vishnuvijayn395/pipet/OneDrive_1_8-5-2026/stage_tab_light_theme_1784133457223.png

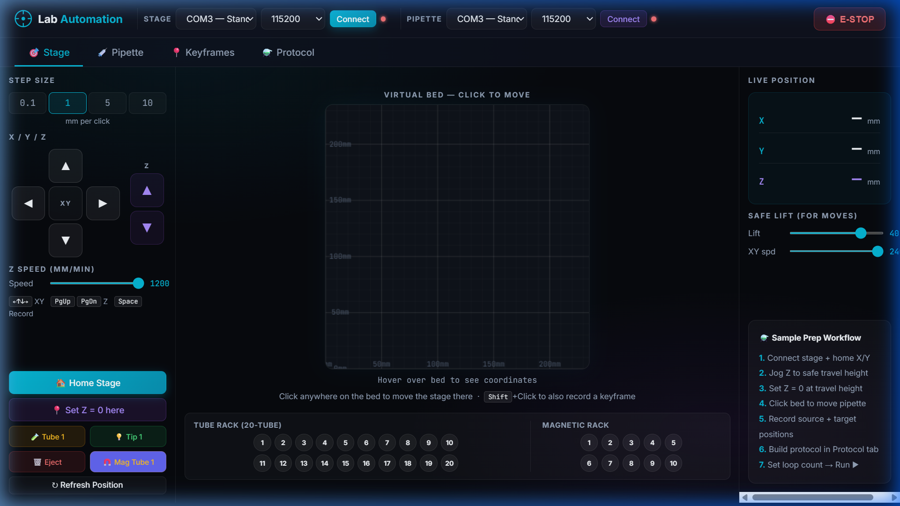
OneDrive_1_8-5-2026/stage_tab_light_theme_1784133457223.png
