vishnuvijayn395/pipet/OneDrive_1_8-5-2026/presentations/electronic_pipette.pptx

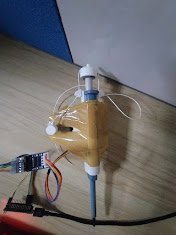
[picture p14: figure]

Prototype v1

Electronic Pipette

Proof of Concept and Initial Hardware Integration

ka

Kahaan Padiya

## Slide 2

The Problem with Manual Pipetting

😓 Repetitive Strain

Hundreds of pipette strokes per day cause thumb and wrist fatigue, leading to RSI in lab technicians.

📉 Human Variability

Manual force inconsistency introduces volume error. CV of manual pipetting can exceed 1–2% for small volumes.

💸 Cost of Error

Inaccurate dispensing wastes expensive reagents and can invalidate entire experiment runs.

⚡ Our Goal

Build a low-cost electronic pipette using off-the-shelf components to improve consistency.

## Slide 3

Hardware Components

01

Arduino Nano

Microcontroller brain. Stores calibration positions in EEPROM, handles serial commands (PREP / ASP / DISP) and jog control.

Provides precise angular positioning. The driver board enables control and handles the current requirements of the Stepper.

Converts rotary Stepper motion into linear plunger travel. String is routed over two force-redirector for smooth, vertical actuation.

Browser-based UI (Web Serial API). No app install needed — connect over USB, calibrate endpoints, and run standard pipetting protocol.

A limit switch at maximum plunger depth will kill the motor, protecting the mechanism and auto-detecting the blowout position.

02

Stepper Motor + Driver

03

Pulley & String System

04

Web Serial Controller

05

Future: Pressure Switch

## Slide 4

Operating Protocol

Three Physical buttons on the pipette to control each stage

PREP

PREP Button

1. Push to First Stop

Press PREP button. Stepper drives plunger to pre-aspirate position and establishes consistent volume baseline before liquid contact.

ASP

ASP Button

2. Aspirate

Press ASP button. Motor retracts plunger to calibrated aspirate depth. Immerse tip first; negative pressure draws liquid in accurately.

DISP

DISP Button

3. Dispense & Blowout

Press DISP button. Full plunger travel to second stop — dispenses volume and completes blowout, expelling all residual liquid.

## Slide 5

Two Interfaces, Two Roles

LAPTOP · One-Time Calibration

Done once. Saved permanently to EEPROM.

Jog UP / DOWN

Use ↑↓ buttons to manually position plunger at the desired depth.

Set Open Position (ZERO)

Save the resting / top-of-travel position. Plunger fully retracted.

Save 1st Stop (Aspirate)

Motor at the exact depth that draws the correct volume into the tip.

Save 2nd Stop (Blowout)

Deepest point : full plunger depression to expel all residual liquid.

Recalibrate only when needed.

PHYSICAL BUTTONS (V1.1) · Daily Operation

No laptop. Just the pipette.

PREP

Push to 1st Stop

ASP

Aspirate Liquid

DISP

Dispense & Blowout

Reads positions from EEPROM at boot. Works standalone.

1

2

VS

3

4

## Slide 6

Precision Comparison: Normal vs Electronic

Manual Pipette

Readings taken at 520nm

Electronic Pipette (v1)

0.47792

0.47687

0.47757

0.54012

0.56028

0.47685

0.47641

0.47592

0.56806

0.54440

Metric | Manual | Electronic
Average | 0.4769 | 0.5532
σ (Sigma) | 0.000733 | 0.01316
3σ | 0.00220 | 0.03948
CV % | 0.154% | 2.379%
3×CV | 0.461% | 7.136%

## Slide 7

Measurement Spread Visualised

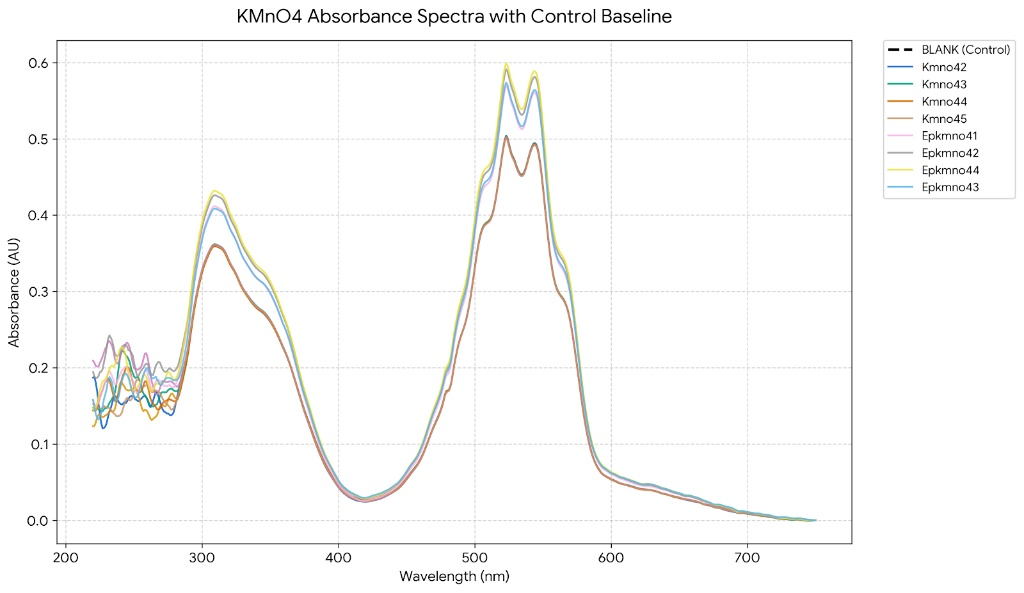
[picture p15: figure]

## Slide 8

Roadmap & Future Improvements

Pressure / Limit Switch + control buttons

Mount a microswitch at maximum plunger depth. Arduino kills motor on trigger. Add Buttons to control Prep, aspirate and dispense.

v1.1

Auto-Calibration Mode

On boot, motor travels to limit switch to find true zero automatically. Calibration saved without manual jog steps.

v1.2

In Progress

Planned

Encoder Feedback

Rotary encoder on Stepper shaft provides closed-loop position control dramatically reduces CV by eliminating string slack error.

v2.0

Volume Selection UI

Add a volume input to the web controller. Software maps desired µL to encoder ticks for flexible, calibrated aspiration.

v2.1

Planned

Future

## Slide 9

Conclusion

A working proof-of-concept in a form factor that costs a fraction of commercial alternatives.

✅ Functional 3-command pipetting protocol over USB Serial

✅ EEPROM-persisted calibration — survives power cycles

✅ Web based browser controller — no install required

📊 CV of 2.38% vs 0.15% manual — improvement path identified

🔧 Pressure switch (v1.1) will fix primary source of error

Built with: Arduino Nano · Stepper Motor · Web Serial API · EEPROM · Open Hardware
