vishnuvijayn395/pipet/OneDrive_1_8-5-2026/presentations/electronic_pipette_v3 (1).pptx

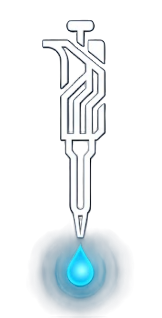
[picture p16: figure]

Electronic Pipette

Prototype v2 · Linear actuator

Precision Improvement via Linear Stepper Control
Comparative Analysis: Control · v1 · v2

Kahaan Padiya · June 2026

## Slide 2

What is v2 — Linear Step Parametrisation

🔩 Linear Actuator step Control

Replaces the Pulley system with force directors, with a industrial grade linear actuator, providing no backlash and much higher precision, Repeatability

📐 Automatic Calibration

Step parameters are configurable via serial interface. At startup, the pipette automatically homes using a contact switch at the bottom of piston stroke. Volume maps directly to step count, enabling reproducible and tunable aspiration depth.

🧪 Tighter Test Protocol

The readings are taken at 8uL, down from the 50uL, showing that the improvement in variation stays constant at lower volumes.

🎯 Target Improvement

v1 showed CV of 2.38% – mainly from string-slack at mechanical stops. v3 aims to bring CV below 0.8% by removing the string and using a direct screw drive.

## Slide 3

Raw Readings @ 520 nm — All Three Conditions

Direct absorbance values used for statistical comparison

Manual Pipette (Control)

Electronic v1

Electronic v3 (Linear Step)

Reading 1

0.47792

Reading 1

0.54012

Reading 1

0.57070

Reading 2

0.47687

Reading 2

0.56028

Reading 2

0.57237

Reading 3

0.47757

Reading 3

0.56806

Reading 3

0.57199

Reading 4

0.47685

n = 4

Reading 4

0.54440

Reading 4

0.57524

n = 6

Reading 5

Reading 6

0.47641

0.47592

n = 5

Reading 5

0.56357

## Slide 4

Precision Metrics — Control vs v1 vs v3

Metric

Manual (Control)

Electronic v1

Electronic v3 (Linear)

Average

0.47692

0.55322

0.57077

σ (Sigma)

0.000733

0.01316

0.00436

3σ

0.00220

0.0395

0.01307

CV %

0.154%

2.379%

0.763%

3×CV

0.461%

7.136%

2.289%

Readings taken at 520 nm · Pathlength 10 mm · Green = best, Red = worst CV

## Slide 5

CV % Comparison — Improvement Across Versions

Control CV

0.154%

v1 CV

2.379%

v3 CV

0.763%

v3 is 68% better CV than v1

## Slide 6

Individual Reading Spread — All Conditions

## Slide 7

Analysis — What v3 Tells Us

✅ CV cut from 2.38% → 0.76%

Linear step control dramatically reduced inter-reading variability. The 68% improvement over v1 confirms that string-slack at mechanical stops was the dominant source of error.

📊 Volume control implemented

Through weighing scale calibration, we can now correlate volume with step count, and control the volume via the app interface

⚠️ Still 5× above manual baseline

Control CV = 0.154%. v3 at 0.76% is a major step forward but further work remains. Likely sources: Flex in 3d print, loss of motor power due to sideways torque

🔧 Next steps to close the gap

Adding a pressure switch for self calibration

## Slide 8

Conclusion

Electronic Pipette v3 — Linear Step Parametrisation

✅ CV reduced from 2.38% (v1) → 0.76% (v3) — a 68% improvement

✅ Linear step control eliminates stop-dependency and string-slack errors

✅ 3σ band tightened from 0.0395 (v1) to 0.0131 (v3) absorbance units

✅ Volume control enabled using step count and calibration with weighing scale
