vishnuvijayn395/pipet/OneDrive_1_8-5-2026/current_stage_tab_1784134485276.png

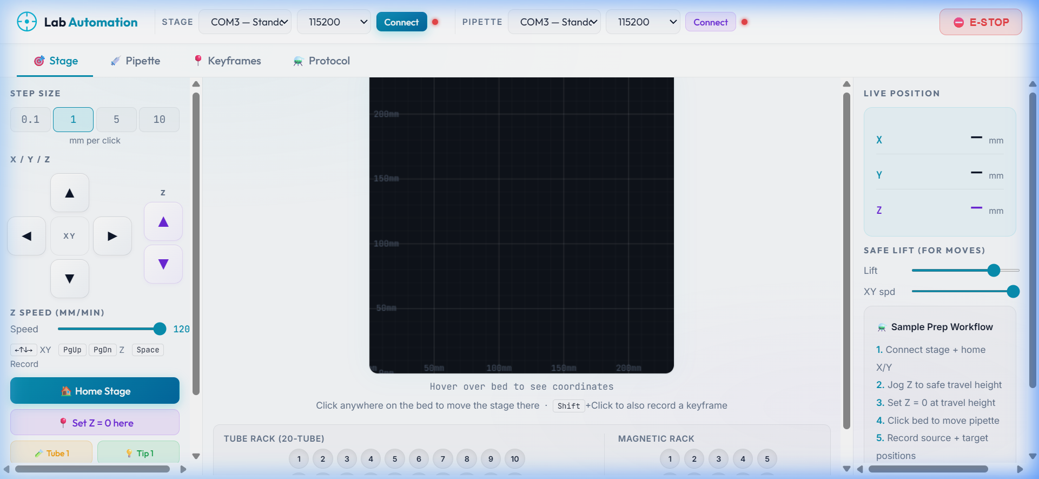
OneDrive_1_8-5-2026/current_stage_tab_1784134485276.png
