vishnuvijayn395/pipet/OneDrive_1_8-5-2026/graphs/overlapping_spectra.png

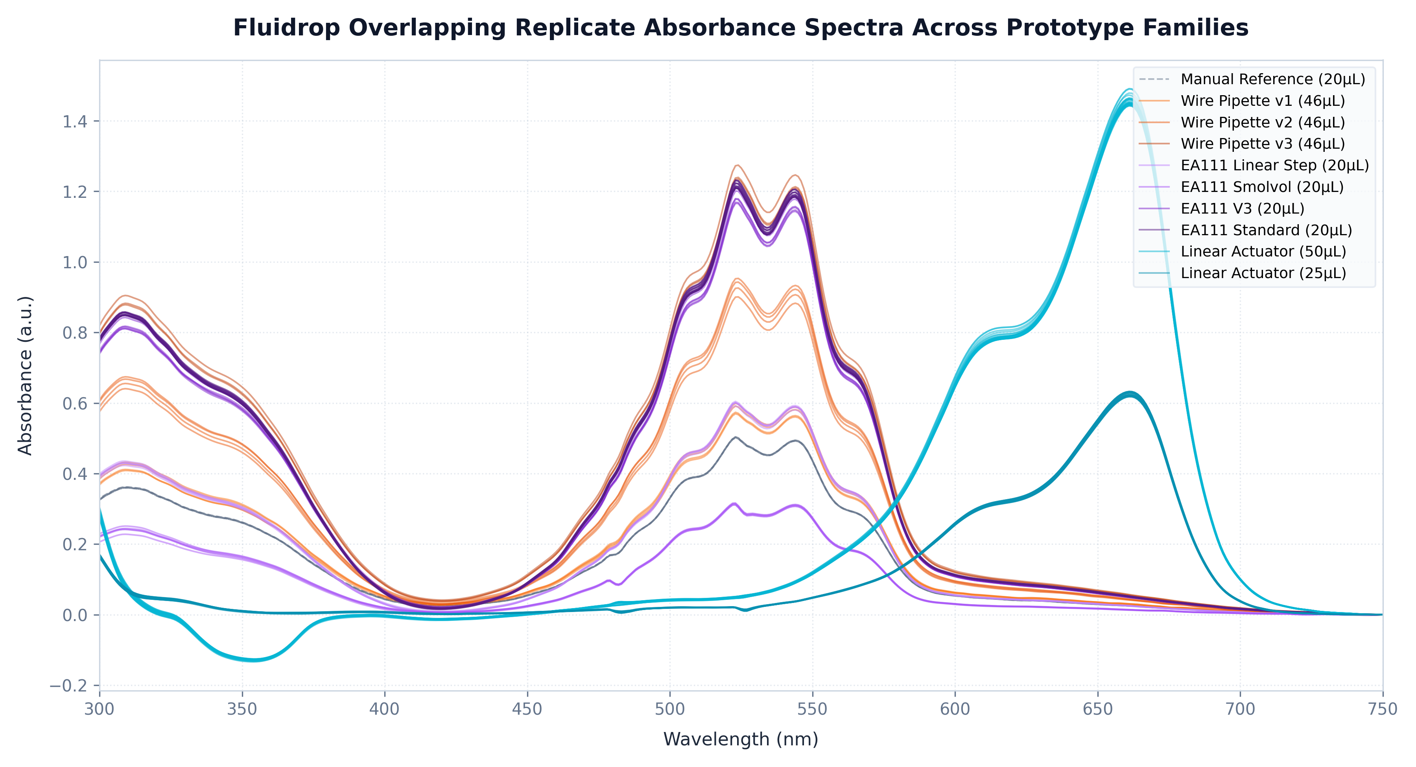
OneDrive_1_8-5-2026/graphs/overlapping_spectra.png
