vishnuvijayn395/pipet/OneDrive_1_8-5-2026/graphs/precision_evolution.png

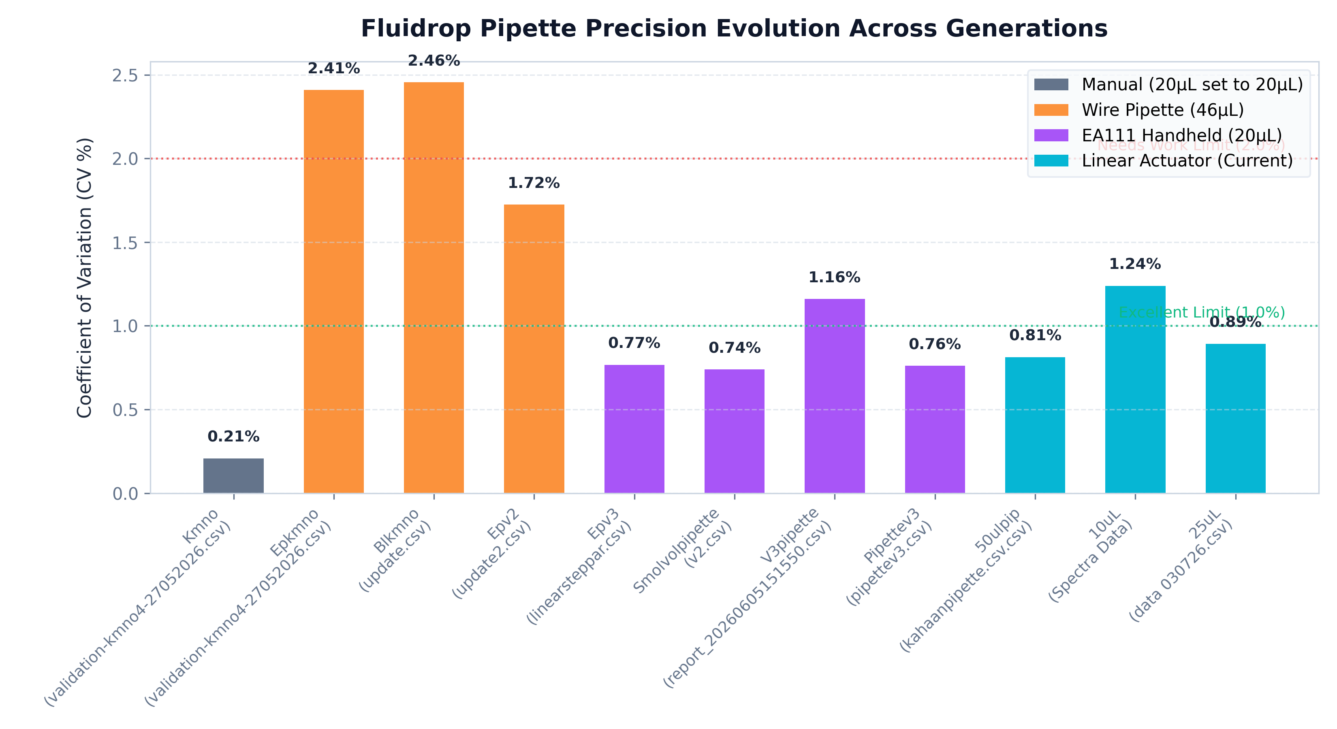
OneDrive_1_8-5-2026/graphs/precision_evolution.png
