vishnuvijayn395/pipet/OneDrive_1_8-5-2026/3d files/Final linear actuator parts/newstrongholder.stl

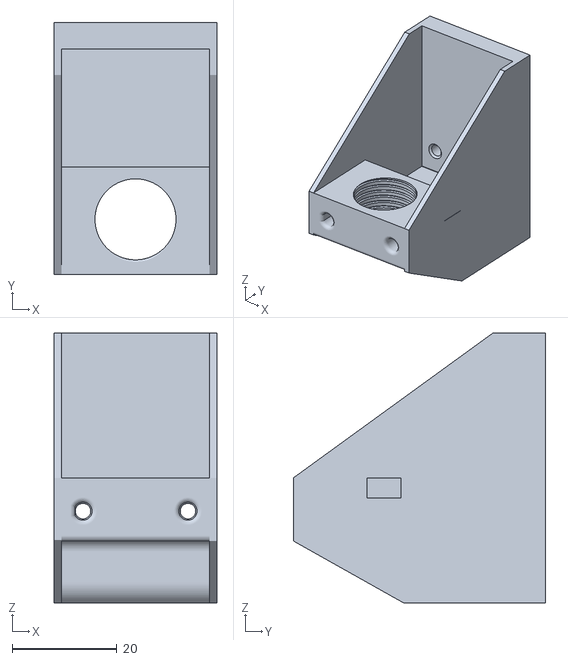
[picture p20: CAD file, 2026-10-06]
OneDrive_1_8-5-2026/3d files/Final linear actuator parts/newstrongholder.stl
31.0 x 48.0 x 51.4
