vishnuvijayn395/pipet/OneDrive_1_8-5-2026/3d files/Handheld linear actuator prototype casing/lowerpipette.stl

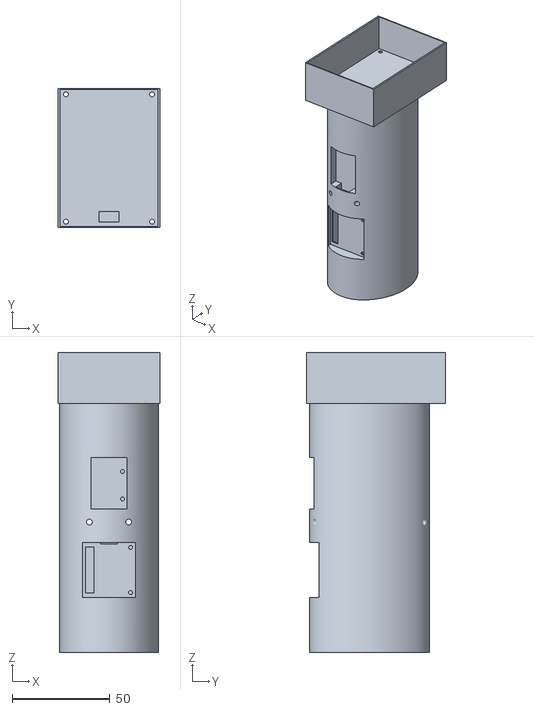
[picture p21: CAD file, 2026-10-06]
OneDrive_1_8-5-2026/3d files/Handheld linear actuator prototype casing/lowerpipette.stl
52.0 x 71.0 x 153.2
