vishnuvijayn395/pipet/OneDrive_1_8-5-2026/3d files/Linear actuator prototype/pushpin.stl

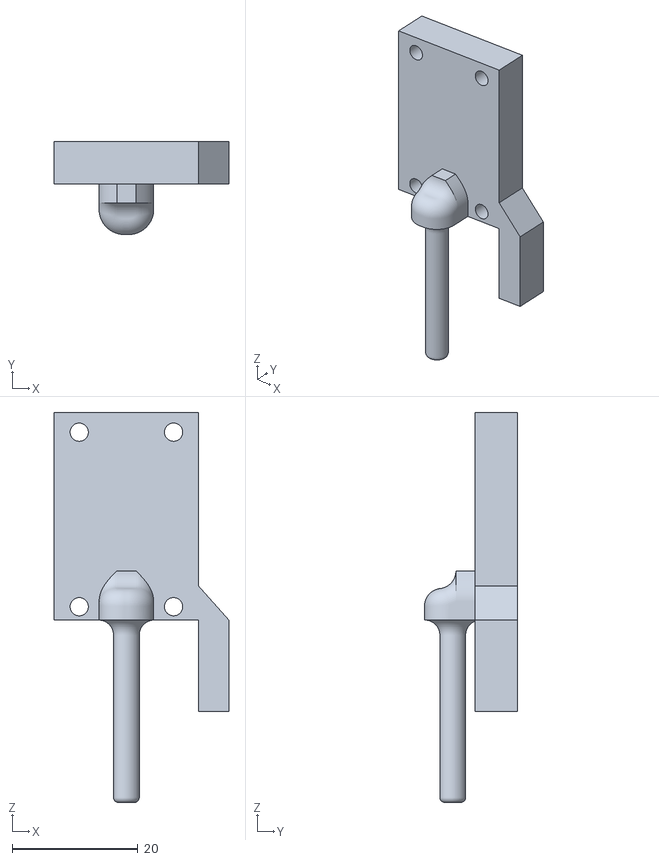
[picture p22: CAD file, 2026-10-06]
OneDrive_1_8-5-2026/3d files/Linear actuator prototype/pushpin.stl
27.8 x 14.8 x 62.0
