vishnuvijayn395/pipet/OneDrive_1_8-5-2026/3d files/PipetteLinearActuatorPrototypeA.3mf

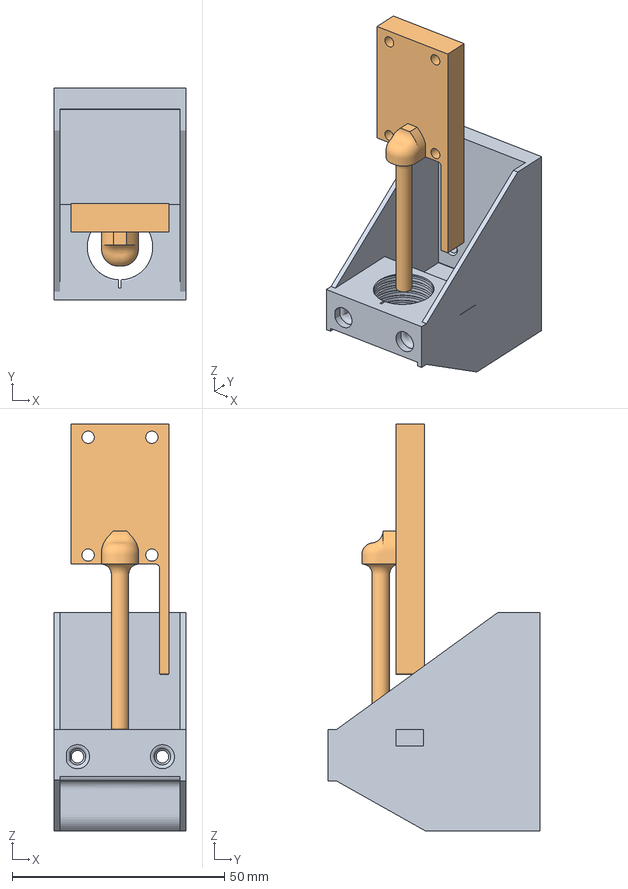
[picture p23: CAD file, 2026-10-06]
OneDrive_1_8-5-2026/3d files/PipetteLinearActuatorPrototypeA.3mf
31.0 x 50.0 x 95.9 mm
