vishnuvijayn395/pipet/OneDrive_1_8-5-2026/3d files/prototype 1 - Pulley/pulley.3mf

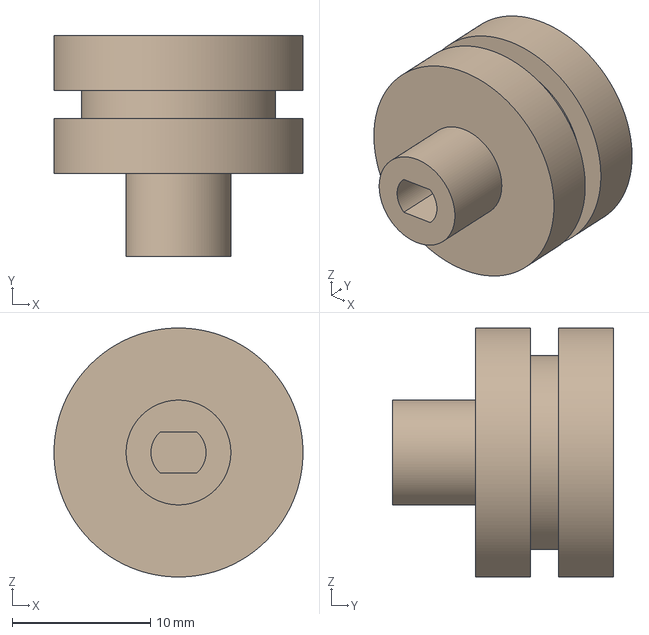
[picture p24: CAD file, 2026-10-06]
OneDrive_1_8-5-2026/3d files/prototype 1 - Pulley/pulley.3mf
18.0 x 16.0 x 18.0 mm
