vishnuvijayn395/pipet/OneDrive_1_8-5-2026/3d files/Syringe prototype parts/Syringepipettewithguiderod.stl

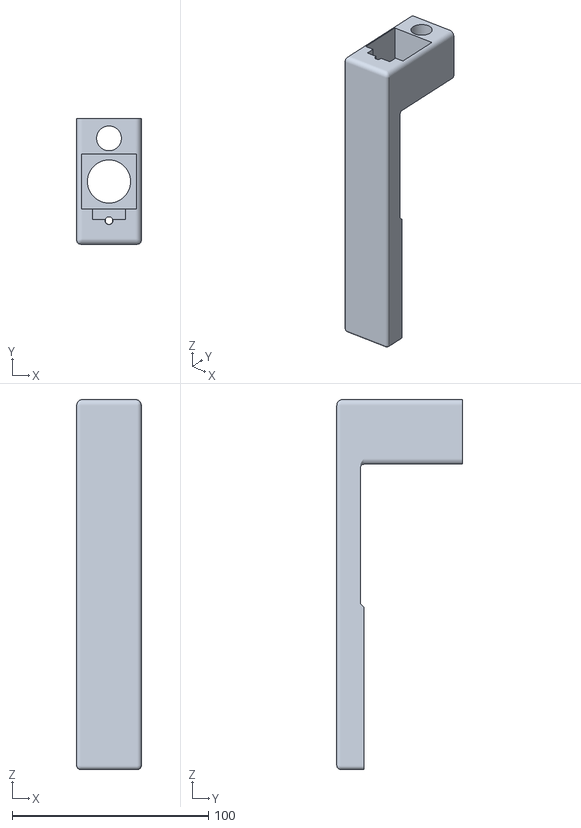
[picture p26: CAD file, 2026-10-06]
OneDrive_1_8-5-2026/3d files/Syringe prototype parts/Syringepipettewithguiderod.stl
33.0 x 64.0 x 188.7
