vishnuvijayn395/pipet/OneDrive_1_8-5-2026/3d files/ec11_encoder_knob.3mf

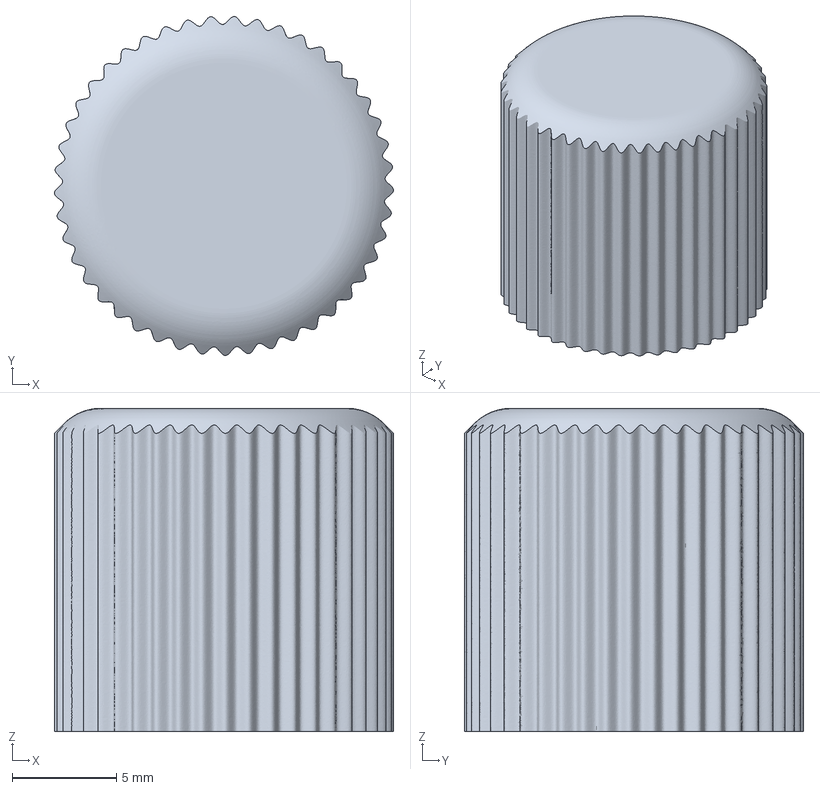
[picture p27: CAD file, 2026-10-06]
OneDrive_1_8-5-2026/3d files/ec11_encoder_knob.3mf
16.3 x 16.2 x 15.5 mm
