vishnuvijayn395/pipet/OneDrive_1_8-5-2026/3d files/Final linear actuator parts/newstrongpin.stl

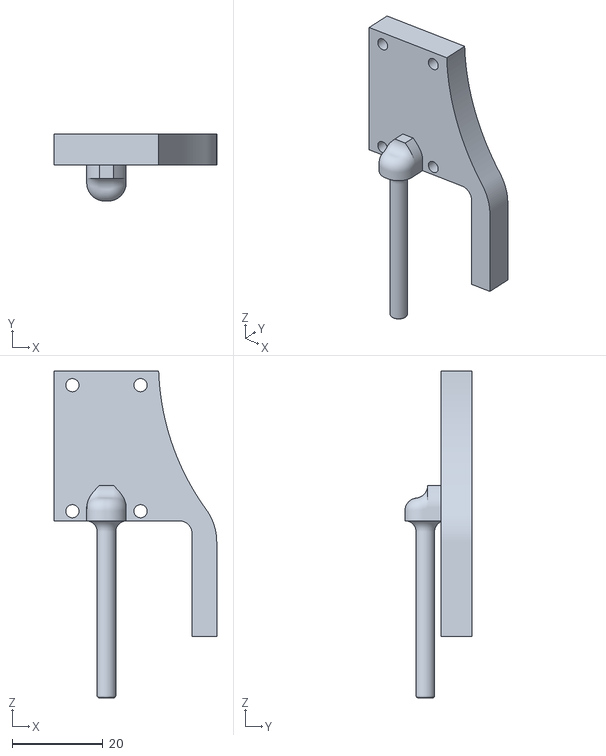
[picture p28: CAD file, 2026-10-06]
OneDrive_1_8-5-2026/3d files/Final linear actuator parts/newstrongpin.stl
35.8 x 14.8 x 72.0
