vishnuvijayn395/pipet/OneDrive_1_8-5-2026/3d files/prototype 1 - Pulley/V and motor mount.3mf

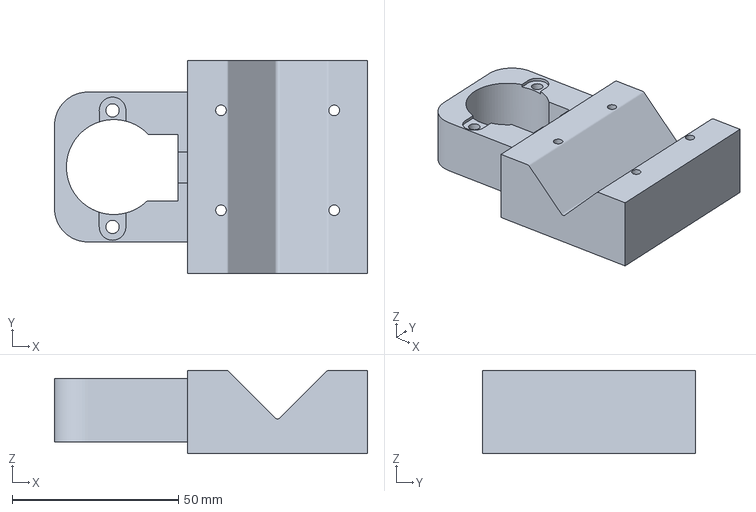
[picture p29: CAD file, 2026-10-06]
OneDrive_1_8-5-2026/3d files/prototype 1 - Pulley/V and motor mount.3mf
94.0 x 64.0 x 25.0 mm
