vishnuvijayn395/pipet/OneDrive_1_8-5-2026/3d files/Prototype 2 - Handheld EA111/pipettepart2.stl

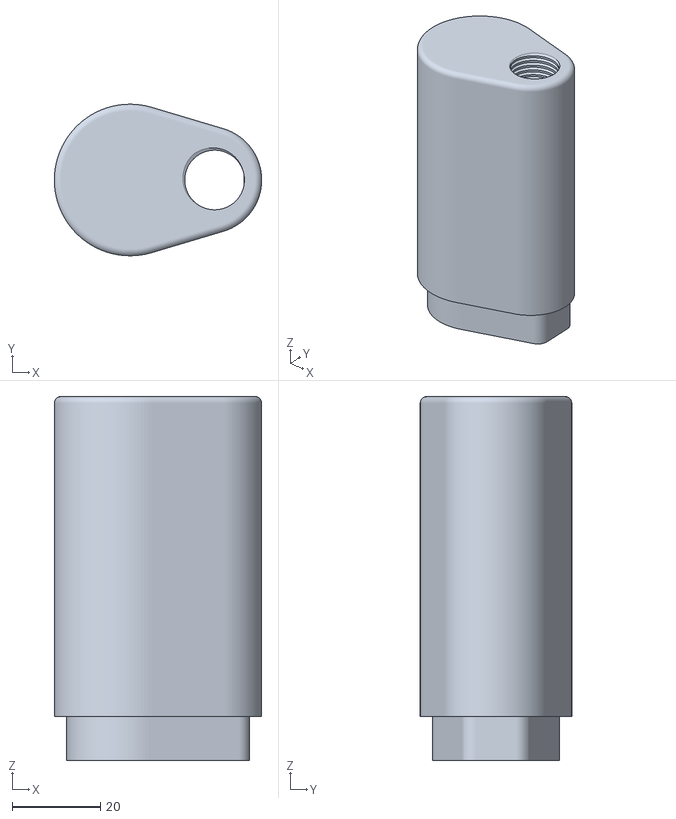
[picture p30: CAD file, 2026-10-06]
OneDrive_1_8-5-2026/3d files/Prototype 2 - Handheld EA111/pipettepart2.stl
47.1 x 34.4 x 82.6
