vishnuvijayn395/pipet/OneDrive_1_8-5-2026/3d files/Prototype 2 - Handheld EA111/connectorfixed.stl

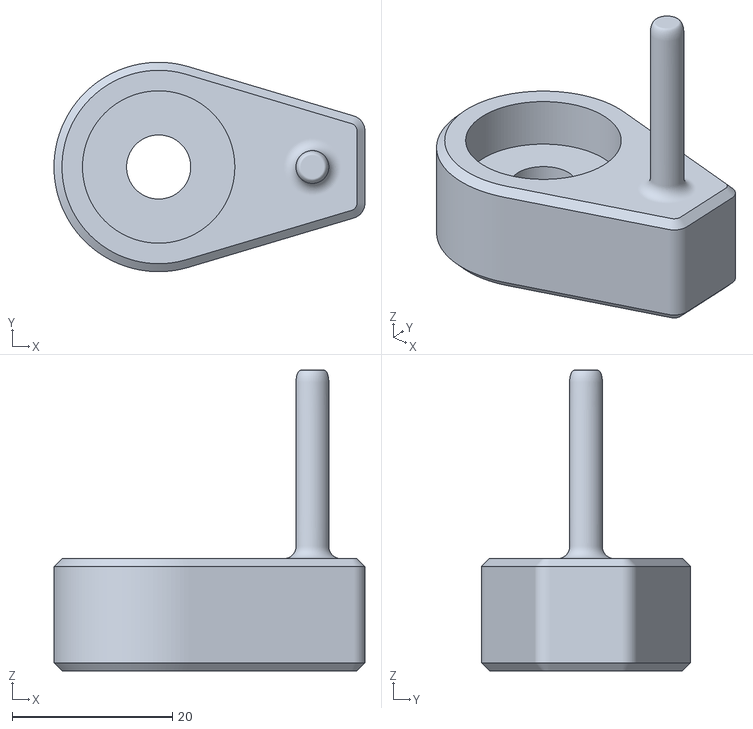
[picture p32: CAD file, 2026-10-06]
OneDrive_1_8-5-2026/3d files/Prototype 2 - Handheld EA111/connectorfixed.stl
38.8 x 26.1 x 37.5
