vishnuvijayn395/pipet/OneDrive_1_8-5-2026/3d files/Syringe prototype parts/Syringepipettewithguiderod_Holder.stl

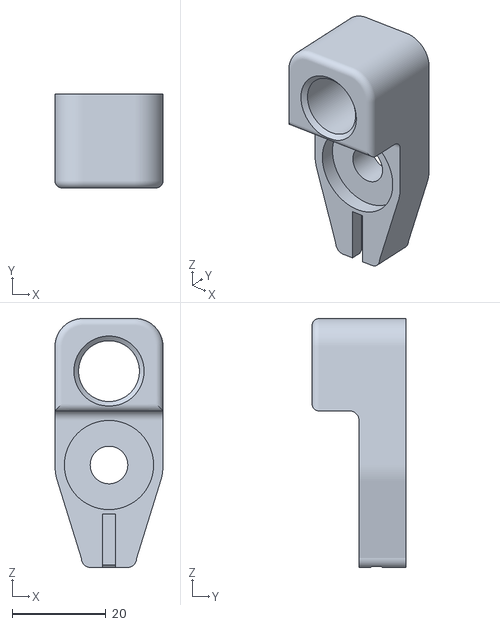
[picture p33: CAD file, 2026-10-06]
OneDrive_1_8-5-2026/3d files/Syringe prototype parts/Syringepipettewithguiderod_Holder.stl
23.0 x 20.0 x 53.0
