vishnuvijayn395/pipet/OneDrive_1_8-5-2026/3d files/Prototype 2 - Handheld EA111/pipette part 1.stl

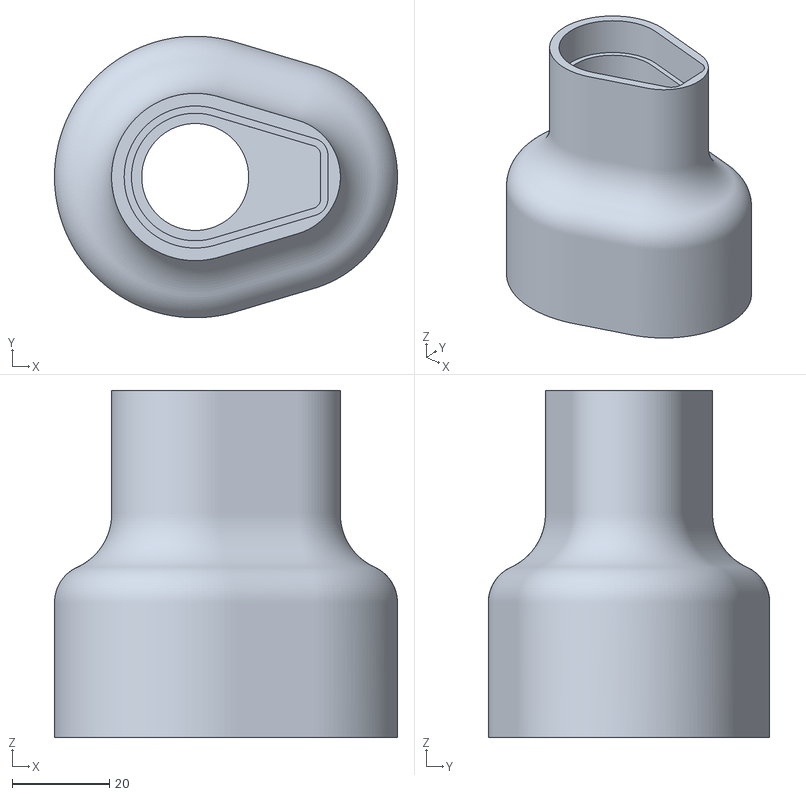
[picture p35: CAD file, 2026-10-06]
OneDrive_1_8-5-2026/3d files/Prototype 2 - Handheld EA111/pipette part 1.stl
70.6 x 57.9 x 71.4
