vishnuvijayn395/pipet/OneDrive_1_8-5-2026/3d files/Syringe prototype parts/syringeconnecotr.stl

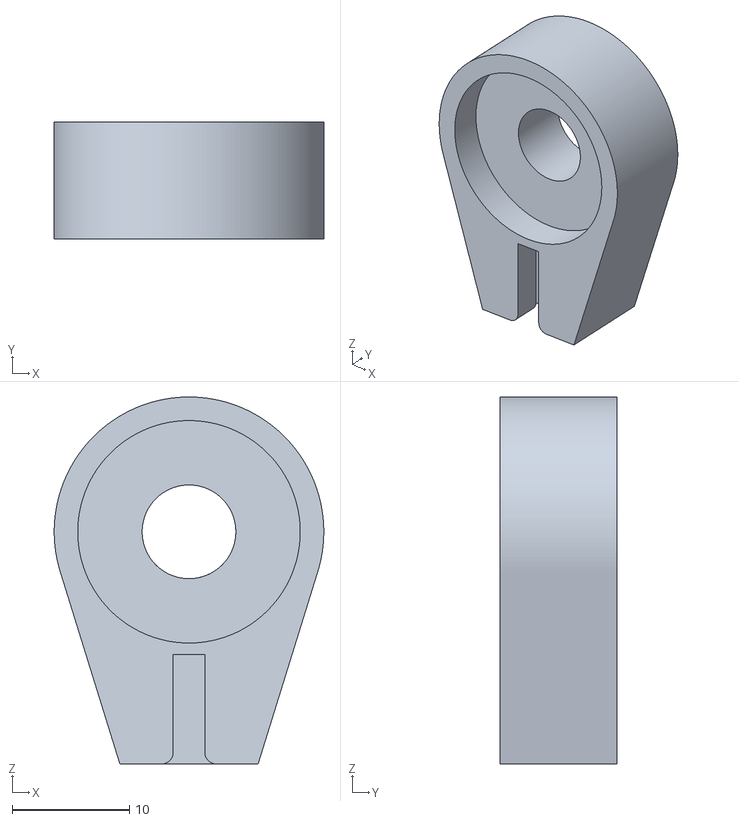
[picture p36: CAD file, 2026-10-06]
OneDrive_1_8-5-2026/3d files/Syringe prototype parts/syringeconnecotr.stl
23.0 x 10.0 x 31.3
