vishnuvijayn395/pipet/OneDrive_1_8-5-2026/3d files/Linear actuator prototype/connecotrrrr.stl

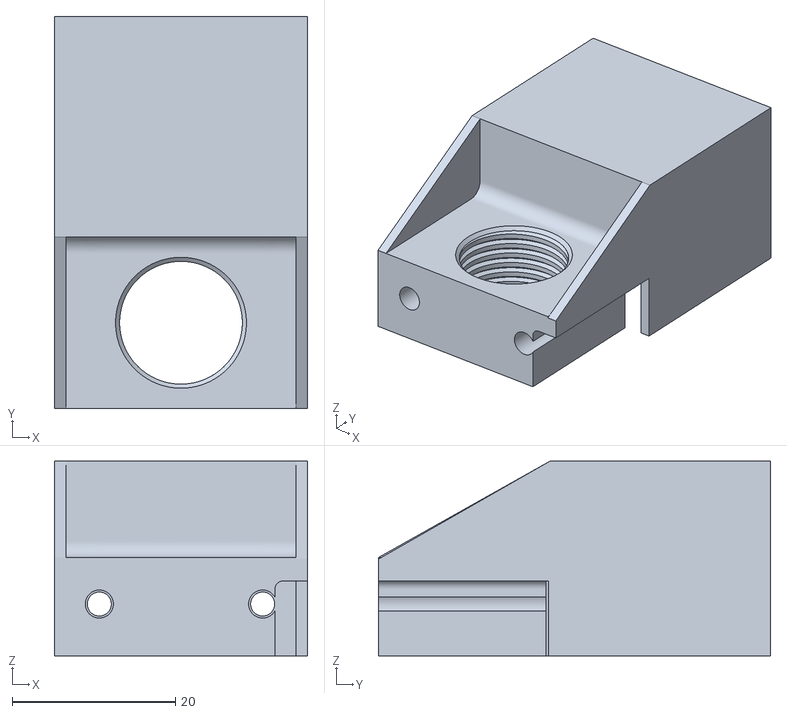
[picture p37: CAD file, 2026-10-06]
OneDrive_1_8-5-2026/3d files/Linear actuator prototype/connecotrrrr.stl
31.0 x 48.0 x 23.9
