vishnuvijayn395/pipet/OneDrive_1_8-5-2026/3d files/Prototype 2 - Handheld EA111/new1-100pipettetop.stl

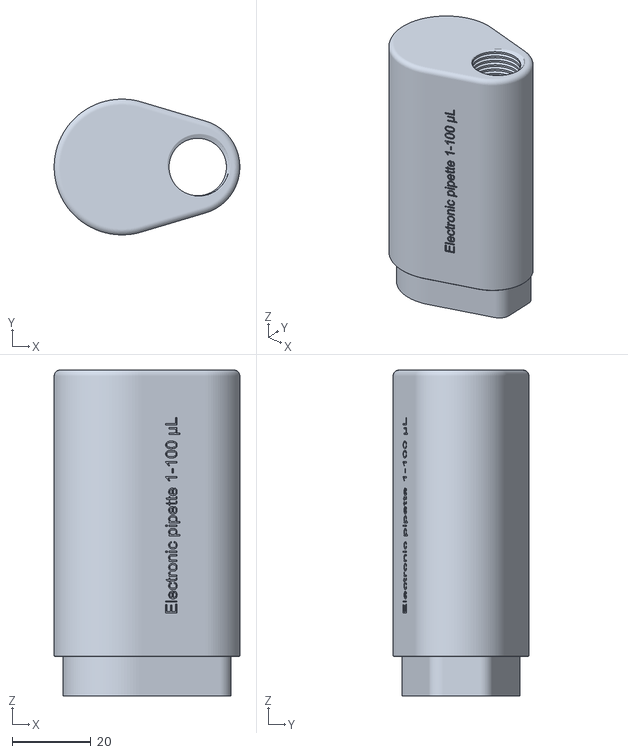
[picture p38: CAD file, 2026-10-06]
OneDrive_1_8-5-2026/3d files/Prototype 2 - Handheld EA111/new1-100pipettetop.stl
47.1 x 34.4 x 82.6
