vishnuvijayn395/pipet/OneDrive_1_8-5-2026/3d files/Syringe prototype parts/longermount.stl

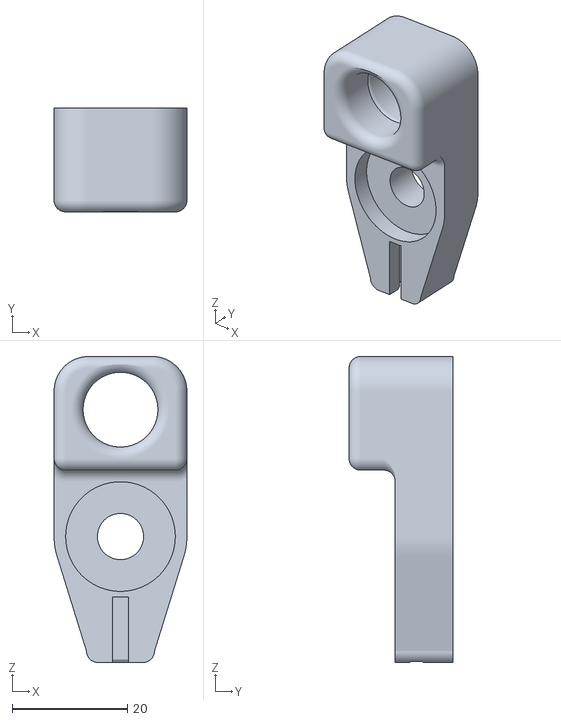
[picture p39: CAD file, 2026-10-06]
OneDrive_1_8-5-2026/3d files/Syringe prototype parts/longermount.stl
23.0 x 18.0 x 53.0
