vishnuvijayn395/pipet/OneDrive_1_8-5-2026/3d files/Prototype 2 - Handheld EA111/smallpipette.3mf

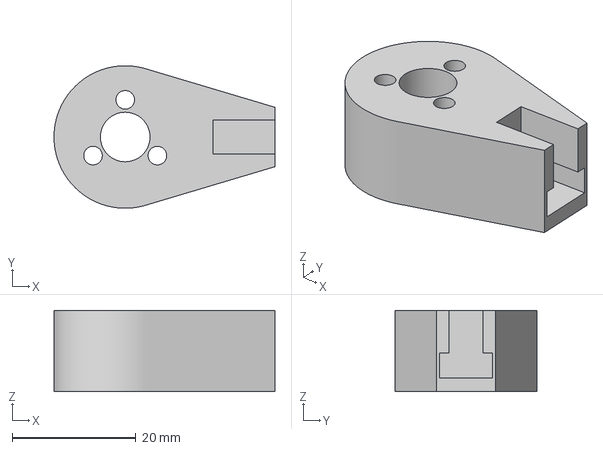
[picture p40: CAD file, 2026-10-06]
OneDrive_1_8-5-2026/3d files/Prototype 2 - Handheld EA111/smallpipette.3mf
35.7 x 23.0 x 13.2 mm
