vishnuvijayn395/pipet/OneDrive_1_8-5-2026/3d files/Syringe prototype parts/syringeconnector.stl

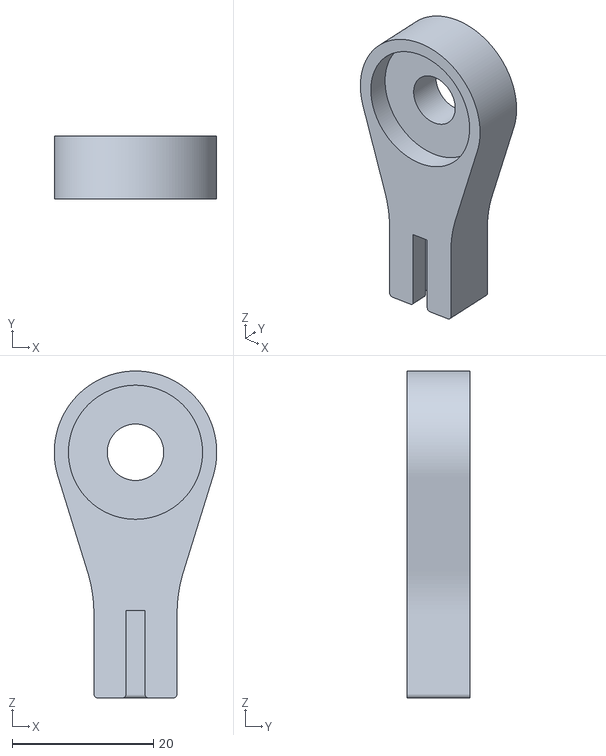
[picture p41: CAD file, 2026-10-06]
OneDrive_1_8-5-2026/3d files/Syringe prototype parts/syringeconnector.stl
23.0 x 9.00 x 46.3
