vishnuvijayn395/pipet/OneDrive_1_8-5-2026/3d files/Prototype 2 - Handheld EA111/newpipettte test connector .stl

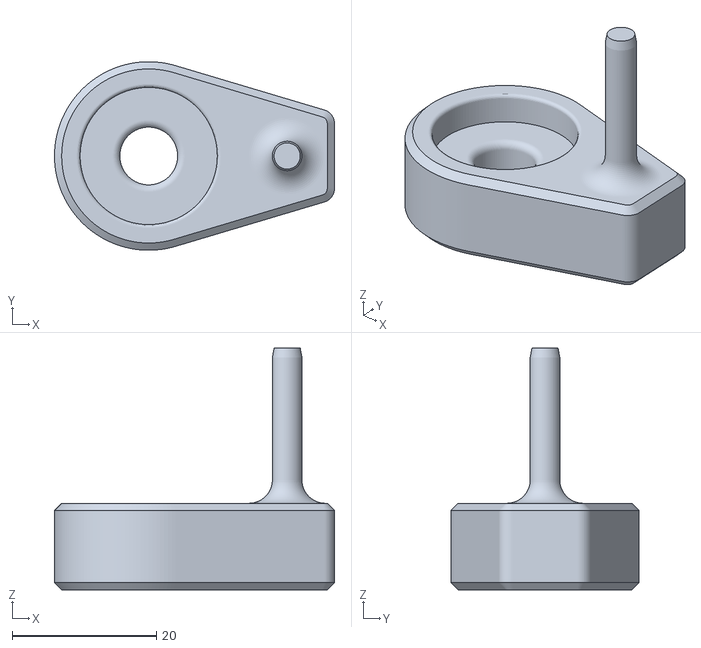
[picture p42: CAD file, 2026-10-06]
OneDrive_1_8-5-2026/3d files/Prototype 2 - Handheld EA111/newpipettte test connector .stl
38.8 x 26.1 x 33.5
