vishnuvijayn395/pipet/OneDrive_1_8-5-2026/3d files/Syringe prototype parts/syringe test.stl

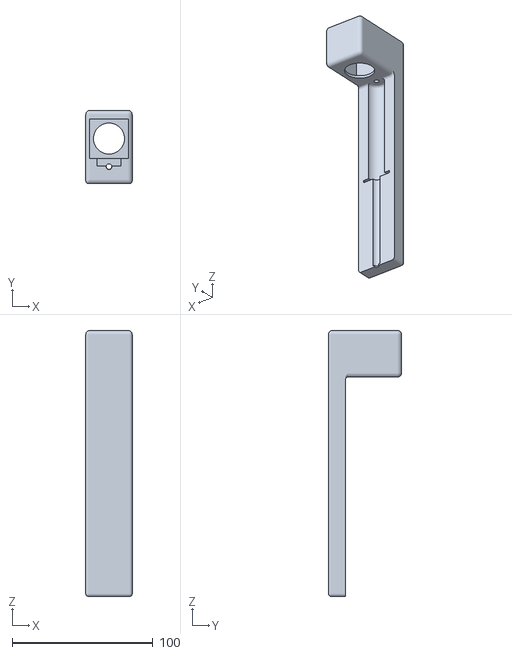
[picture p43: CAD file, 2026-10-06]
OneDrive_1_8-5-2026/3d files/Syringe prototype parts/syringe test.stl
33.0 x 52.0 x 188.7
