vishnuvijayn395/pipet/(list of files, cad)

Other CAD files:
OneDrive_1_8-5-2026/3d files/Handheld linear actuator prototype casing/lowerhalfpipette.stl
OneDrive_1_8-5-2026/3d files/Syringe prototype parts/syringeprint.stl
OneDrive_1_8-5-2026/3d files/prototype 1 - Pulley/newbackplate.3mf
OneDrive_1_8-5-2026/3d files/Syringe prototype parts/fixedsyringe.stl
OneDrive_1_8-5-2026/3d files/Prototype 2 - Handheld EA111/Bodypipette.stl
