vishnuvijayn395/pipet/OneDrive_1_8-5-2026/testmotor.html

# AutoPipette

▶ Run Protocol

⚙️ Calibration

🛠️ Settings

Disconnected

Connect via USB Disconnect

Auto-connect

Run Protocol

Active Multiplier: - steps/µL

## Protocol Configuration

Full Volume Stroke

Custom Aliquot Repetition

Variable Pipette Mode

Total Aspirate Volume (µL)

Aliquot Dispense Volume (µL)

Set Volume (µL)

## Execution

Back to Home Pre-Wet Tip Purge Tip

Connect to Begin

USB Connection Required

⬆️ Aspirate ⬇️ Dispense & Blowout 🔄 Return to Ready (First Stop)

## Progress Dashboard

Contained Volume

0.0 µL

Remaining Aliquots

0 reps

Last Limit Switch Hit Position (Drift Monitor)

Aspirate Progress

## Positional Calibration

Use the jog buttons to align the linear actuator, then save the hard stop limits.

⟲ Move UP Move DOWN ⟳

EMERGENCY STOP 🔧 Auto-Home (Restore Sync)

Drift Check (20x)

1. Open Position (Zero)

Topmost position. Used as reference zero.

Go To Sync Save

2. First Stop

Start of aspiration range.

Go To Sync Save

3. Blowout

Lowest purge limit. Limit switch on D2.

Go To Sync Save 🏠 Find & Save Blowout

Overshoot past switch (steps): Set Motor jogs until switch fires, then travels this many extra steps before saving blowout.

## Multi-Point Accuracy Calibration

Inactive Enable

Interpolated compensation curve to correct for mechanical non-linearity.

Target (µL) Measured (µL)

+ Add Point Save & Apply Clear All

Export CSV Import CSV

## Total Syringe Capacity

Used to calculate the steps/µL multiplier across the First Stop to Blowout range.

Calculate

## Motor Speed

Max Speed (steps/s): 800 Deceleration (steps/s²): 500

## Serial Console Log
