vishnuvijayn395/pipet/OneDrive_1_8-5-2026/Raw data/extra data/pipette_calibration.csv

Target (uL) | Measured (uL)
1 | 0.8
2.5 | 1.8
5 | 4
7.5 | 6.8
10 | 8.5
20 | 18.5
30 | 27.9
40 | 39.2
50 | 48.7
60 | 58.8
70 | 68.9
80 | 78.7
90 | 89.1
100 | 99
