vishnuvijayn395/pipet/OneDrive_1_8-5-2026/Raw data/pipette_calibration_20260701_180148.csv

Target Volume (uL) | Iteration | Measured Value
1 | 1 | 0.9
1 | 2 | 1.0
1 | 3 | 1.1
2.5 | 1 | 2.5
2.5 | 2 | 2.6
2.5 | 3 | 2.7
5 | 1 | 4.9
5 | 2 | 4.9
5 | 3 | 5.2
7.5 | 1 | 7.4
7.5 | 2 | 7.6
7.5 | 3 | 7.6
10 | 1 | 9.8
10 | 2 | 9.8
10 | 3 | 10.1
25 | 1 | 25.3
25 | 2 | 25.1
25 | 3 | 25.2
50 | 1 | 49.8
50 | 2 | 49.7
50 | 3 | 50.0
75 | 1 | 75.6
75 | 2 | 75.5
75 | 3 | 75.7
100 | 1 | 100.1
100 | 2 | 100.0
100 | 3 | 100.2
