vishnuvijayn395/pipet/OneDrive_1_8-5-2026/Raw data/validation-kmno4-27052026.csv

Sample Number | Sample Name | nm 1 | Abs 1 | nm 2 | Abs 2 | nm 3 | Abs 3 | nm 4 | Abs 4 | nm 5 | Abs 5 | nm 6 | Abs 6 | Pathlength (mm) | Date/Time | Baseline nm | Baseline abs | Min nm | Max nm | Account | Session | Measure Type | Instrument | Exposure | 220 | 221 | 222 | 223 | 224 | 225 | 226 | 227 | 228 | 229 | 230 | 231 | 232 | 233 | 234 | 235 | 236 | 237 | 238 | 239 | 240 | 241 | 242 | 243 | 244 | 245 | 246 | 247 | 248 | 249 | 250 | 251 | 252 | 253 | 254
0 | BLANK |  |  |  |  |  |  |  |  |  |  |  |  |  | 2026-05-27 13:19 |  |  |  |  | General | 1,155 | B
2 | Kmno42 | 430 | 0.028 | 565 | 0.29 | 412 | 0.0269 | 550 | 0.438 | 427 | 0.0265 | 560 | 0.305 | 10 | 2026-05-27 13:26 | 750 | 0.00848 | 220 | 750 | General | 1,155 | M | S-11451:DSC:v5.1.1:FW7.88:DB61: | Cuv:CFULL:12:2:4:67:13:a0:L10000:S0:LPA0.000:SPA0.000 | 0.18707 | 0.18800 | 0.18008 | 0.16871 | 0.15235 | 0.13919 | 0.12705 | 0.12039 | 0.12106 | 0.12306 | 0.12796 | 0.13597 | 0.14275 | 0.14730 | 0.15370 | 0.15967 | 0.16315 | 0.16150 | 0.15799 | 0.15435 | 0.15273 | 0.15163 | 0.15298 | 0.15498 | 0.15360 | 0.15627 | 0.15902 | 0.16213 | 0.16265 | 0.16349 | 0.16161 | 0.15855 | 0.15755 | 0.15609 | 0.15695
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
