vishnuvijayn395/pipet/OneDrive_1_8-5-2026/graphs/calibration_curve.png

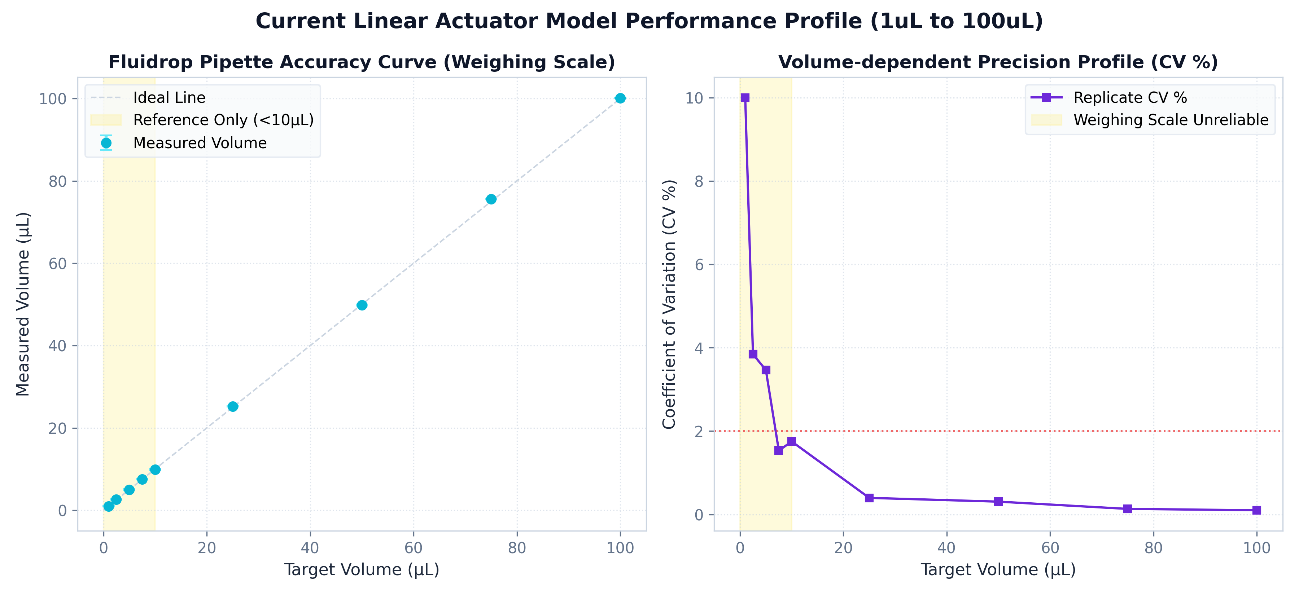
OneDrive_1_8-5-2026/graphs/calibration_curve.png
